LattePandaTeam/LattePanda-Mu/Mechanicals/LattePanda_Mu_Dimension_Drawing.dxf

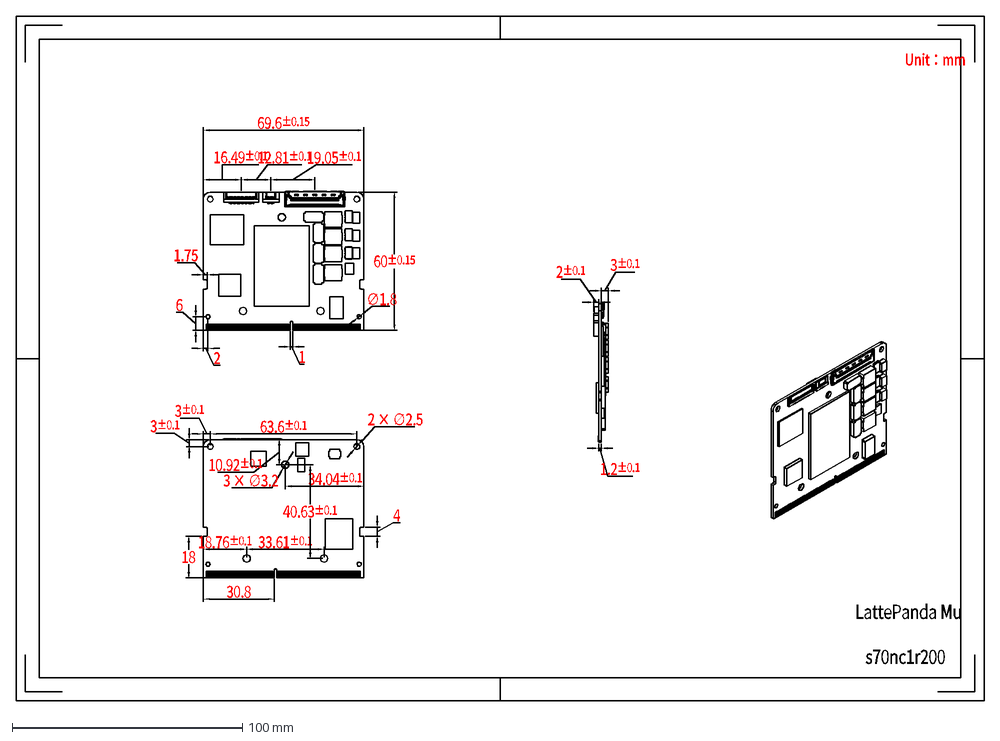
[picture p1: CAD file, 2024-08-19]
Mechanicals/LattePanda_Mu_Dimension_Drawing.dxf
s70nc1r200
LattePanda Mu
Unit：mm
69.6±0.15
60±0.15
1.75
∅1.8
6
2
1
18
30.8
4
3±0.1
2 × ∅2.5
63.6±0.1
3 × ∅3.2
10.92±0.1
34.04±0.1
33.61±0.1
18.76±0.1
40.63±0.1
16.49±0.1
12.81±0.1
19.05±0.1
1.2±0.1
2±0.1
